skim743/gritsbotx_vicon_hats/README.md

# gritsbotx_vicon_hats
Code to generate hats configuration, CAD model of the hats, drawings for laser cutting, documentation. Credit: Gennaro Notomista
