skim743/gritsbotx_vicon_hats/documentation/fig/assemble_parts.jpg

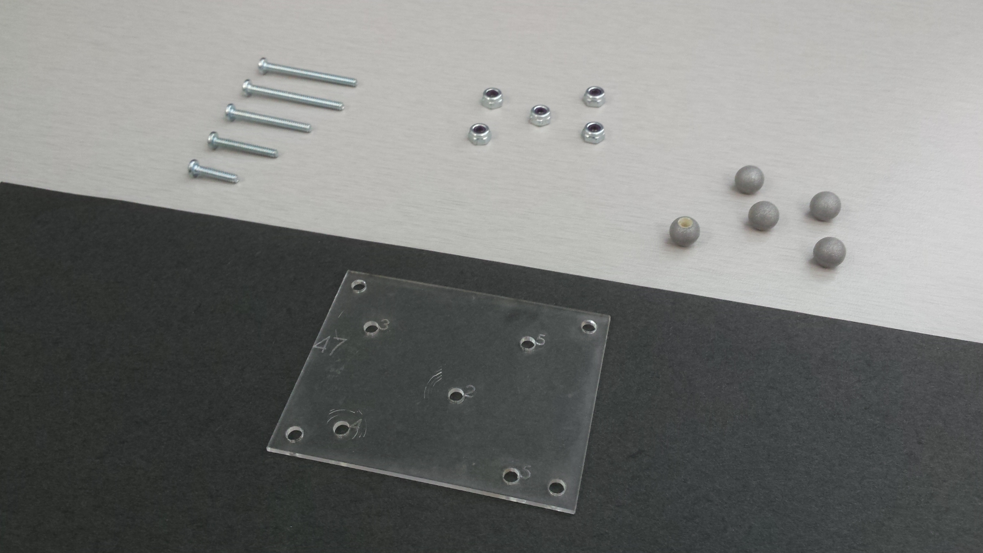
documentation/fig/assemble_parts.jpg
