skim743/gritsbotx_vicon_hats/(list of files, cad)

Other CAD files:
cad_model/SW_drawings/holes_plate_1-40.SLDDRW
cad_model/SW_drawings/holes_plate_41-50.SLDDRW
